chainarong681/portable-pcr-machine-project/README.md

โปรเจ็ค portable pcr machine project ของห้องปฏิบัติการไวรัสวิทยา ของศูนย์วิจัยและพัฒนาการสัตวแพทย์ภาคเหนือตอนล่างจังหวัดพิษณุโลก โดยนายชัยณรงค์ กุลฉิม นักวิทยาศาสตร์การแพทย์ปฏิบัติการ เริ่มต้นโปรเจ็ค 1 พ.ย. 2566
