chainarong681/portable-pcr-machine-project/poster and proceeding/Portable mini PCR และเครื่องตรวจสอบสารพันธุกรรม Isothermal แบบภาคสนาม final 10-1-2566.pdf

### Portable mini PCR และเครื่องตรวจสอบสารพันธุกรรม Isothermal แบบ ภาคสนาม

ความเป็นมา
ปัญหา : การแพร่ระบาดของโรคสัตว์และการติดต่อของโรคสัตว์สู่คนเป็นปัญหาที่ส าคัญ โดยเฉพาะ เชื้อก่อโรคที่ก่อความรุนแรงและมีอัตราการเสียชีวิตที่สูง วิธีการทดสอบที่ให้ผลที่รวดเร็วแบบ Point of care testing (PoCT) จึงมีบทบาทอย่างมากในการช่วยควบคุมโรคให้มีประสิทธิภาพ ปัจจุบันจึงมีการพัฒนาวิธีการ PoCT โดยใช้หลักการเพิ่มปริมาณสารพันธุกรรม Isothermal Amplification เช่นวิธี Loop-mediated isothermal amplification (LAMP) หรือ Recombinase polymerase amplification (RPA)ซึ่งเป็นวิธีการ ที่มีศักยภาพสูง รวดเร็ว สามารถตรวจได้ ณ จุดที่พบโรค แต่ก็ยังพบข้อจ ากัดอยู่ เช่น การอ่านผลได้หลายแบบ ท าให้สับสนในการเลือกใช้งาน ต้องอาศัยประสบการณ์ของผู้ทดสอบในการแปลผล และยังจ าเป็นต้องใช้ เครื่องมือเพิ่มปริมาณสารพันธุกรรม ซึ่งมีราคาค่อนข้างสูงแม้จะใช้เพียงอุณหภูมิเดียว
วัตถุประสงค์: การจัดการองค์ความรู้ในครั้งนี้มีเป้าหมายเพื่อ
1. พัฒนาเครื่องมือ PoCTต้นแบบขนาดเล็ก (Small Handheld PoCT devices) ได้แก่1) Portable mini PCR และ 2) เครื่องตรวจสอบสารพันธุกรรม Isothermal แบบภาคสนาม
2. ทดสอบการใช้งานโดยเลือกใช้วิธี LAMP เป็นต้นแบบ ตรวจหาสารพันธุกรรมของเชื้อไวรัส LSDV จากตัวอย่าง เลือด และตุ่มเนื้อเยื่อ (Laohasatian et al., 2023) โดยท าการปรับวิธีและสารเคมีให้เหมาะสม กับเครื่องต้นแบบ ใช้สีฟลูออเรสเซนต์SYBR green I ในการอ่านและติดตามผลการทดสอบ

วิธีการ
ออกแบบเครื่องมือต้นแบบ โดยใช้ระบบควบคุมการท างานด้วยไมโครคอนโทรลเลอร์ชนิด ESP32 วัด อุณหภูมิทดสอบด้วยเซนเซอร์ชนิด DS18B20 เพื่อควบคุมอุณหภูมิblock ด้วย Peltier ผ่านสัญญาณ PWM ซึ่งควบคุมแบบ Proportional Integral Derivative Control (PID) และอ่านการเรืองแสงของสีSYBR green I ด้วยเซนเซอร์ตรวจวัดสเปกตรัมแสง AS7341 แสดงการประมวลบนจอ LCD ผ่านการสั่งงานบนอุปกรณ์ โทรศัพท์มือถือ

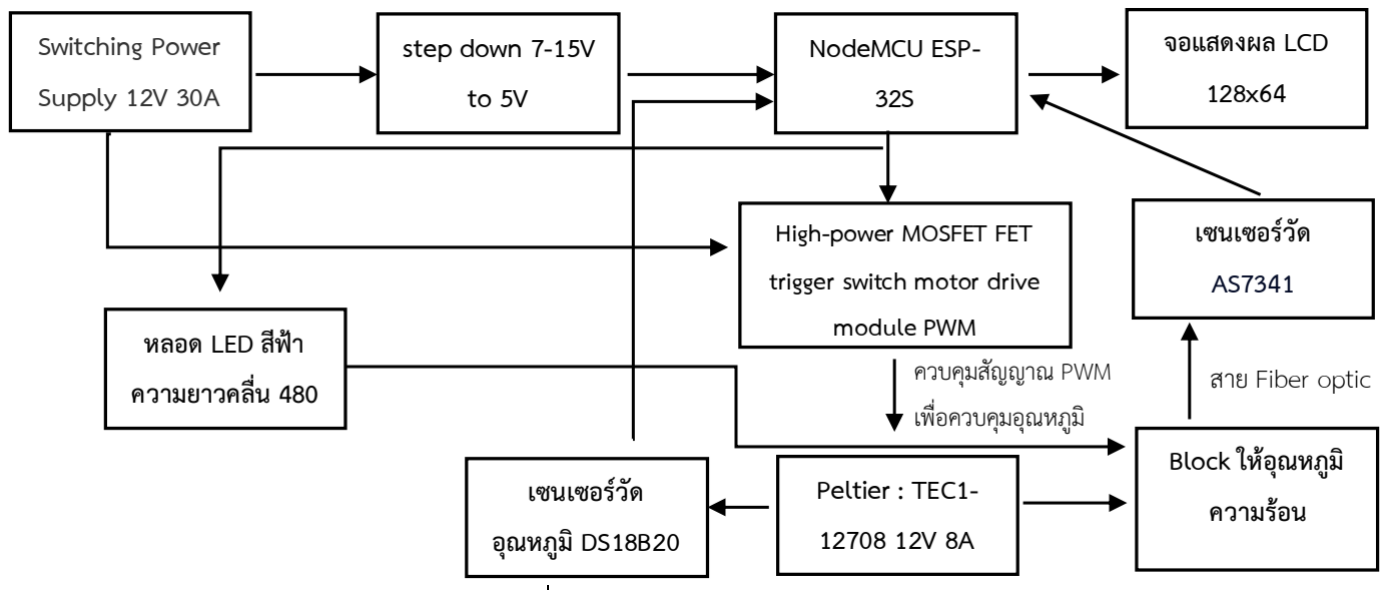
[picture p1: figure]

ภาพแสดงผังวงจรและระบบการท างานเครื่องตรวจสอบสารพันธุกรรม Isothermal แบบภาคสนามต้นแบบ

ผลลัพธ์
1. Portable mini PCR

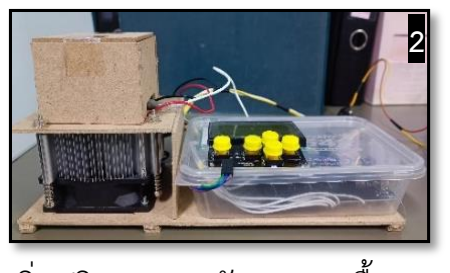
[picture p2: figure]
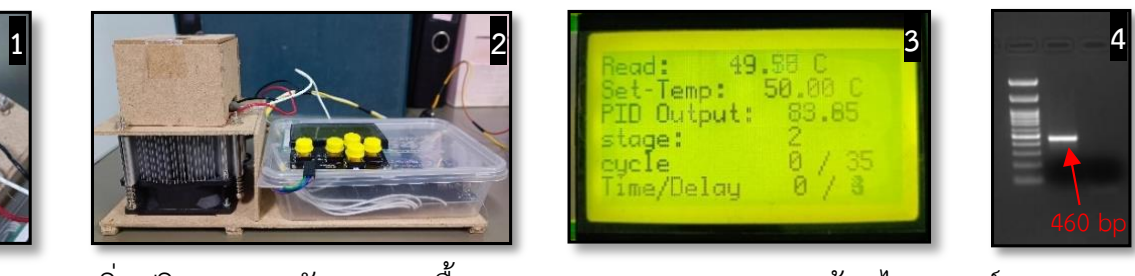
[picture p3: figure]
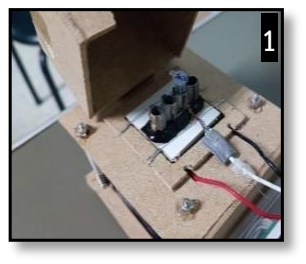
[picture p4: figure]

1.1 ผลการทดสอบเพิ่มปริมาณสารพันธุกรรมเชื้อ Pasteurella multocida ด้วยไพรเมอร์KMT1T7 และ KMT1SP6 (Moustafa et al., 2013) จากชุดเพิ่มปริมาณสารพันธุกรรม Invitrogen™ Platinum™ Taq DNA Polymerase ให้ผลการทดสอบขนาดดีเอ็นเอที่ถูกต้องเท่ากับ 460 bp (รูปที่ 4) ไม่พบ nonspecific band มีค่า Ramp rate เฉลี่ยประมาณ 3 ˚C/Sec (เครื่อง PCR ทางการค้ามีค่าเฉลี่ย 5 ˚C/Sec)
1.2 สามารถน าไปใช้ประโยชน์เป็นเครื่อง PCR ขนาดเล็ก พกพาสะดวก ใช้งานง่าย ใช้เป็น heat block ในการสกัดดีเอ็นเอด้วยวิธี Heat lysis
2. เครื่องตรวจสอบสารพันธุกรรม Isothermal แบบภาคสนาม

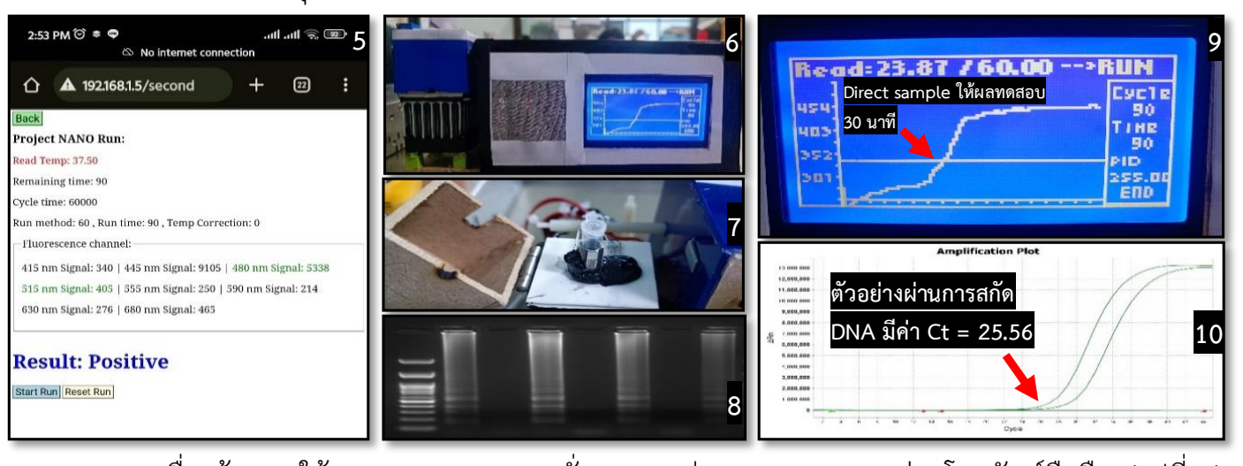
[picture p5: figure]
Direct sample ให้ผลทดสอบ 30 นาที; ตัวอย่างผ่านการสกัด DNA มีค่า Ct = 25.56

2.1 เครื่องต้นแบบใช้งานสะดวก สามารถสั่งงานและอ่านผลการทดสอบผ่านโทรศัพท์มือถือ (รูปที่ 5) มีขนาดเล็กพกพาได้(รูปที่ 6) เจ้าหน้าที่ด้านปศุสัตว์สามารถใช้งานได้ง่าย ราคาถูก ให้ผลรวดเร็ว น าไปใช้ใน การตรวจวินิจฉัย ติดตามอาการ และติดตามการรักษา และควบคุมโรคที่บริเวณหน้าฟาร์มหรือจุดเกิดโรค
2.2 ผลทดสอบการใช้งานตัวอย่างจากเลือดสดเจือจาง 1 : 50 ไม่ผ่านการสกัดสารพันธุกรรมให้ ผลบวกใช้เวลาน้อยกว่า 30 นาที(รูปที่ 9) เปรียบเทียบกับวิธีมาตรฐาน real-time PCR ตัวอย่างผ่านการสกัด ดีเอ็นเอ (รูปที่10) มีค่า Ct = 25.56 ให้ผลบวกภายในเวลา 66 นาทีดังนั้นวิธีนี้จึงเหมาะสมในการที่จะพัฒนา น าไปใช้จริงในภาคสนามต่อไป

น าเสนอโดย นายชัยณรงค์ กุลฉิม นักวิทยาศาสตร์การแพทย์ปฏิบัติการ ศูนย์วิจัยและพัฒนาการสัตวแพทย์ภาคเหนือตอนล่าง

การทดสอบเพื่อเพิ่มความถูกต้องของผลการ ทดสอบ สามารถท าการเจือจางเลือดสด 1:100 ผ่านการท า Heat lysis ที่ 95 ˚C นาน 5 นาที ก่อนท าการทดสอบด้วยวิธีLAMP

1:50 1:100 | ตัวอย่างคาดการว่ามีเชื้อไวรัสในปริมาณน้อยๆ
| (ไม่มีclinical sign) หรือพบค่า Ct จาก real- time PCR > 35 จ าเป็นต้องผ่านการท า Heat lysis ซึ่งจะให้ผลบวกระยะนานกว่า 60 นาที
