chainarong681/portable-pcr-machine-project/Isothermal/Nano_project_sensor24122023.ino

///////////////////////////ส่วน WIFI////////////////////////////////////////
#include <WiFi.h>
#include <WiFiClient.h>
#include <WebServer.h>
#include <ESPmDNS.h>
#include <EEPROM.h>

const char *ssid = "Project_nano";
const char *password = "123456789";

IPAddress apIP(192, 168, 1, 5);
IPAddress gatewayIP(192, 168, 1, 1);
IPAddress subnetIP(255, 255, 255, 0);

WebServer server(80);

///////////////////////////ส่วนแสดง LCD/////////////////////////////////////
#include <PID_v1.h>
#include <Arduino.h>
#include <U8g2lib.h>

#ifdef U8X8_HAVE_HW_SPI
#include <SPI.h>
#endif
#ifdef U8X8_HAVE_HW_I2C
#include <Wire.h>
#endif

U8G2_ST7920_128X64_F_SW_SPI u8g2(U8G2_R0, /* clock=*/18, /* data=*/23, /* CS=*/5, /* reset=*/22);  // ESP32

//loading bar
int boxlong = 0;

//Read temp ทุก 1 นาที
float READTEMP_ONE;

//อ่าน EEPROM เก็บเพื่อใช้เป็นค่า setting
//float methodRUN; //ย้ายไปใช้ที่ PID
int timeRUN;
float temCRUN;

//สถานะการทำงาน
int State_Run = 0;

//ประกาศตัวแปรเป็น global เพื่อเก็บค่าไว้ไม่ให้ reset จากการวนloop
unsigned long last_time = 0;
int period;  //ระยะเวลาสร้างกราฟที่ต้องการรอ 1 นาที (1000 * 60)
int TIME_COUNT = 0;
//Buzzer time count
unsigned long last_timeRead = 0;
unsigned long period2 = 1500;

// อ่านอุณหภูมิทุก 1 นาที แสดงที่จอ
unsigned long periodTemp = 1000; // ระยะเวลาที่ต้องการรอ
static unsigned long last_timeTempREAD = 0; // ประกาศตัวแปรเป็น static เพื่อเก็บค่าไว้ไม่ให้ reset จากการวน loop
float last_timeTemp;

//Set Line graph
float temperature[90];  // Array to store temperature values
int currentIndex;   // Index to keep track of the current position in the array

//คำนวนค่า max และ min กำหนดสเกลของกราฟเพื่อปรับความละเอียดตามค่า
int maxTemp;
int minTemp = 0;
//คำนวนค่าใส่เลเบลแกน Y
int percent20;
int percent40;
int percent60;
int percent80;

//Buzzer
#define BUZZER_PIN 13  // กำหนดขาที่เชื่อมต่อกับ buzzer
int Buzzer_count = 0;

// Control parameters for PID
double READTEMP, Output, methodRUN;
double Kp = 1; // Proportional gain 2 , 1
double Ki = 0.5; // Integral gain 5 , 0.5
double Kd = 0.5; // Derivative gain 1 , 0.5
PID myPID(&READTEMP, &Output, &methodRUN,Kp,Ki,Kd,P_ON_M, DIRECT);

// TEMP DS18B20
#include <OneWire.h>
#include <DallasTemperature.h>
#define ONE_WIRE_BUS 27
OneWire oneWire(ONE_WIRE_BUS);
DallasTemperature sensors(&oneWire);

// Peltier setup
int peltierPin = 33; // Digital pin connected to the Peltier module

//LED สีน้ำเงินเป็นแสง excitation
int ledBluePin = 12;

//AS7341 spectrum sensor
#include <Wire.h>
#include <Adafruit_AS7341.h>
Adafruit_AS7341 as7341;
int NM415; //ค่าอ่านที่ 415 nm
int NM445; //ค่าอ่านที่ 445 nm
int NM480; //ค่าอ่านที่ 480 nm
int NM515; //ค่าอ่านที่ 515 nm
int NM555; //ค่าอ่านที่ 555 nm
int NM590; //ค่าอ่านที่ 590 nm
int NM630; //ค่าอ่านที่ 630 nm
int NM680; //ค่าอ่านที่ 680 nm

//คำนวนค่า CT
float CT_value;
//คำนวนค่า Mean
float mean = 0.0;
float mean_val[20]; //เก็บค่า 20 ค่า
float sampleSumTotal = 0;
int mean_i; //ค่าที่จะให้รันซ้ำ
float SD_SumV = 0;
float Stdv_value = 0;
int SD_i;
//สถานะผลทดสอบ
String report_result;

/////////////////////////////////WIFI//////////////////////////////////////
// Function to write a string to EEPROM
void writeStringToEEPROM(int addr, const String &str) {
  for (size_t i = 0; i < str.length(); i++) {
    EEPROM.write(addr + i, str[i]);
  }
  EEPROM.write(addr + str.length(), '\0');  // Null-terminate the string
  EEPROM.commit();                          // Commit changes to EEPROM
}

// Function to read a string from EEPROM
String readStringFromEEPROM(int addr) {
  String result = "";
  char ch = EEPROM.read(addr);
  while (ch != '\0') {
    result += ch;
    addr++;
    ch = EEPROM.read(addr);
  }
  return result;
}

void handleRoot() {
  String html = "<html><body>";
  html += "<h1 style=\"color:blue;\">Project nano</h1>";
  html += "<h2 style=\"color:black;\">This project was developed by Mr. Chainarong Kulchim (medical scientist) </h2>";
  html += "<h2 style=\"color:black;\">Veterinary Research and Development Center Lower Northern Region</h2>";
  html += "<h2 style=\"color:black;\">9 Moo.15 Phitsanulok-Lomsak road Wangthong Phitsanulok 65130</h2>";
  html += "<h2 style=\"color:black;\">Email: chainarong681@gmail.com Tel.0805040716</h2>";

  // เพิ่มขนาดและเปลี่ยนสีปุ่ม
  html += "<button style=\"font-size: 30px; background-color: lightgreen;\" onclick=\"goToSecondPage()\">Run program</button>  ";
  html += "<button style=\"font-size: 30px; background-color: lightyellow;\" onclick=\"goToThirdPage()\">Setting program</button>  ";
  html += "<button style=\"font-size: 30px; background-color: lightpink;\" onclick=\"goToFourthPage()\">Calibration</button>";

  html += "<script>function goToSecondPage() { window.location.href = '/second'; }</script>";
  html += "<script>function goToThirdPage() { window.location.href = '/third'; }</script>";
  html += "<script>function goToFourthPage() { window.location.href = '/Fourth'; }</script>";
  html += "</body></html>";

  server.send(200, "text/html", html);
}

void handleSecondPage() {
  String html = "<html><body>";
  html += "<button style='font-size: 30px; background-color: lightgreen;' onclick='goToRoot()'>Back</button>";
  html += "<h1>Project NANO Run:</h1>";
  html += "<p style='font-size: 28px; color: red;'>Read Temp: " + String(last_timeTemp) + "</p>";
  html += "<p style='font-size: 28px;'>Remaining time: " + String(TIME_COUNT) + "</p>";
  
  // Read values from EEPROM
  String method = readStringFromEEPROM(0);
  String time = readStringFromEEPROM(5);
  String tempC = readStringFromEEPROM(10);
  String CycleTime = readStringFromEEPROM(40);

  // html += "<p style='font-size: 28px;'>Run method: " + method + "</p>";
  // html += "<p style='font-size: 28px;'>Run time: " + time + "</p>";
  // html += "<p style='font-size: 28px;'>Temp Correction: " + tempC + "</p>";

  //ตั้งค่าเวลาใน 1 cycle
  html += "<p style='font-size: 28px;'>Cycle time: " + CycleTime + "</p>";
  
  //เชื่อมต่อข้อความ
  html += "<p style='font-size: 28px;'>Run method: " + method + " \n " + ", Run time: " + time + " \n " + ", Temp Correction: " + tempC + "</p>";

  //แสดงสัญญาณ
  html += "<fieldset style='font-size: 28px;'>";
  html += "<legend>Fluorescence channel:</legend>"; // กำหนดชื่อ GroupBox ด้วย Legend
  html += "<p style='font-size: 25px;'>415 nm Signal: " + String(NM415) + " | " +
            "445 nm Signal: " + String(NM445) + " | <span style='color: green; font-size: 25px;'>480 nm Signal: " + String(NM480) + "</span></p>";
  html += "<p><span style='color: green; font-size: 25px;'>515 nm Signal: " + String(NM515) + "</span> | " +
            "555 nm Signal: " + String(NM555) + " | " +
            "590 nm Signal: " + String(NM590) + "</p>";
  html += "<p style='font-size: 25px;'>630 nm Signal: " + String(NM630) + " | " +
            "680 nm Signal: " + String(NM680) + "</p>";
  html += "</fieldset><br>";

  //ส่งผลการทดสอบ
  // html += "<h1 style='font-size: 55px; color: blue;'>Result: " + report_result + "</h1>";

 // Display test result with dynamic color
  html += "<h1 style='font-size: 55px; ";
  if (report_result == "Positive") {
    html += "color: red;'>Result: Positive</h1>";
  } else if (report_result == "Negative") {
    html += "color: green;'>Result: Negative</h1>";
  } else {
    html += "color: black;'>Please wait for test results after cycle 25</h1>";
  }
  
  // เพิ่มปุ่ม Start Run และ Stop Run
  html += "<button style='font-size: 28px; background-color: lightblue;' onclick='startRun()'>Start Run</button> ";
  html += "<button style='font-size: 28px; background-color: lightyellow;' onclick='resetRun()'>Reset Run</button> ";
  html += "<script>";
  html += "function startRun() {";
  html += "  if (confirm('Are you sure to start RUN?')) {";
  html += "    fetch('/startRun', { method: 'POST' })";
  html += "      .then(response => response.json())";
  html += "      .then(data => {";
  html += "        console.log('State_Run updated:', data.State_Run);";
  html += "      });";
  html += "  }";
  html += "}";
  html += "function resetRun() {";
  html += "  if (confirm('Are you sure you want to reset Run?')) {";
  html += "    fetch('/resetRun', { method: 'POST' })";
  html += "      .then(response => response.json())";
  html += "      .then(data => {";
  html += "        console.log('State_Run updated:', data.State_Run);";
  html += "      });";
  html += "  }";
  html += "}";
  html += "</script>";
  html += "<script>function goToRoot() { window.location.href = '/'; }</script>";
  html += "</body></html>";

  server.send(200, "text/html", html);
}

void handleThirdPage() {
  String html = "<html><body>";
  html += "<button style='font-size: 30px; background-color: lightgreen;' onclick='goToRoot()'>Back</button>";
  html += "<h1>Amplification method setting:</h1>";
  html += "<form action='/submit' method='post'>";
  html += "<label for='methods' style='font-size: 24px;'>Choose a method: </label>";
  html += "<select name='methods' id='methods' style='font-size: 24px;'>";
  html += "<option value='37'>Recombinase Polymerase Amplification(37 'C)</option>";
  html += "<option value='42'>Recombinase Polymerase Amplification(42 'C)</option>";
  html += "<option value='60'>Loop-mediated isothermal amplification(60 'C)</option>";
  html += "<option value='61'>Loop-mediated isothermal amplification(61 'C)</option>";
  html += "<option value='62'>Loop-mediated isothermal amplification(62 'C)</option>";
  html += "<option value='63'>Loop-mediated isothermal amplification(63 'C)</option>";
  html += "<option value='64'>Loop-mediated isothermal amplification(64 'C)</option>";
  html += "<option value='65'>Loop-mediated isothermal amplification(65 'C)</option>";
  html += "</select><br><br>";
  html += "<label for='time' style='font-size: 24px;'>Choose a time: </label>";
  html += "<select name='time' id='time' style='font-size: 24px;'>";
  html += "<option value='30'>30 min</option>";
  html += "<option value='60'>60 min</option>";
  html += "<option value='90'>90 min</option>";
  html += "<option value='2'>self test 2 min</option>";
  html += "</select><br><br>";
  html += "<label for='timeCycles' style='font-size: 24px;'>Please select the data collection time per cycle: </label>";
  html += "<select name='timeCycles' id='timeCycles' style='font-size: 24px;'>";
  html += "<option value='60000'>60 sec</option>";
  html += "<option value='1000'>1 sec</option>";
  html += "</select><br><br>";
  html += "<input type='submit' value='Submit' style='font-size: 20px; width: 100px; height: 30px; background-color: yellow;'>";
  html += "</form>";
  html += "<script>function goToRoot() { window.location.href = '/'; }</script>";
  html += "</body></html>";

  server.send(200, "text/html", html);
}

void handleThirdPageSubmit() {
  //////////////////////////ถ้าเขียน EEPROM แล้วมีปัญหา อาจเกิดการ reset อยู่ตลอดเวลให้แก้โดยใช้โค้ดลบ EEPROM ถึง 4096 และอัพโหลดโค้ดใหม่ดดยเลือก erase all flash ด้วยโดยทำตามลำดับ
  //////////////////////////หรือใช้วิธี ใช้โค้ดลบ EEPROM ถึง 4096 และอัพโหลดโค้ดใหม่ดดยเลือก erase all flash พร้อมกัน
  String method = server.arg("methods");
  String time = server.arg("time");
  String timeCycle = server.arg("timeCycles");

  // Assuming you have enough space in EEPROM for the method and time strings
  writeStringToEEPROM(0, method);
  writeStringToEEPROM(5, time);
  writeStringToEEPROM(40, timeCycle);

  // Print the saved values to Serial
  //Serial.println("Method: " + method);
  //Serial.println("Time: " + time);

  // Assuming you have some condition to determine success or failure
  bool success = true;  // Change this based on your actual condition

  String message;
  String color;

  if (success) {
    message = "Data saved successfully";
    color = "green";
  } else {
    message = "Failed to save data";
    color = "red";
  }

  String html = "<html><body>";
  html += "<h1 style='color:" + color + "'>" + message + "</h1>";
  html += "<button style='font-size: 30px; background-color: lightgreen;' onclick='goToThirdPage()'>Back</button>";
  html += "<script>function goToThirdPage() { window.location.href = '/third'; }</script>";
  html += "</body></html>";

  server.send(200, "text/html", html);
}

void handleFourthPage() {
  String html = "<html><body>";
  html += "<button style='font-size: 30px; background-color: lightgreen;' onclick='goToRoot()'>Back</button>";
  html += "<h1 style='font-size: 24px;'>Temperature calibration:</h1>";
  // เพิ่มฟอร์ม input ข้อมูล
  html += "<form action='/submitFourth' method='post' onsubmit='return validateForm()'>";
  html += "<label for='tempC' style='font-size: 24px;'>Temp correction ('C): </label>";
  html += "<input type='text' id='tempC' name='tempC' style='font-size: 24px;' required><br><br>";
  html += "<input type='submit' value='Submit' style='font-size: 20px; width: 100px; height: 30px; background-color: yellow;'>";
  html += "</form>";

  html += "<script>";
  html += "function validateForm() {";
  html += "  var tempCValue = document.getElementById('tempC').value;";
  html += "  if (!tempCValue || isNaN(tempCValue)) {";
  html += "    alert('Please enter a valid numeric value for Temp correction.');";
  html += "    return false;";
  html += "  }";
  html += "}";
  html += "</script>";


  html += "<script>function goToRoot() { window.location.href = '/'; }</script>";
  html += "</body></html>";

  server.send(200, "text/html", html);
}

void handleFourthPageSubmit() {
  String tempC = server.arg("tempC");

  // Assuming you have enough space in EEPROM for the tempC string
  writeStringToEEPROM(10, tempC);

  // Print the saved value to Serial
  //Serial.println("Temp Correction: " + tempC);

  // Assuming you have some condition to determine success or failure
  bool success = true;  // Change this based on your actual condition

  String message;
  String color;

  if (success) {
    message = "Temperature correction saved successfully";
    color = "green";
  } else {
    message = "Failed to save data";
    color = "red";
  }

  String html = "<html><body>";
  html += "<h1 style='color:" + color + "'>" + message + "</h1>";
  html += "<button style='font-size: 30px; background-color: lightgreen;' onclick='goToFourthPage()'>Back</button>";
  html += "<script>function goToFourthPage() { window.location.href = '/Fourth'; }</script>";
  html += "</body></html>";

  server.send(200, "text/html", html);
}
/////////////////////////////////WIFI//////////////////////////////////////

void setup(void) {
  WiFi.softAP(ssid, password);
  delay(100);

  WiFi.softAPConfig(apIP, gatewayIP, subnetIP);

  server.begin();

  server.on("/", HTTP_GET, handleRoot);

  server.on("/second", HTTP_GET, handleSecondPage);

  server.on("/third", HTTP_GET, handleThirdPage);
  server.on("/submit", HTTP_POST, handleThirdPageSubmit);  // New route for form submission

  server.on("/Fourth", HTTP_GET, handleFourthPage);
  server.on("/submitFourth", HTTP_POST, handleFourthPageSubmit);

  server.on("/startRun", HTTP_POST, [](){
  State_Run = 1; // ตั้งค่า State_Run เมื่อได้รับ request
  server.send(200, "application/json", "{\"State_Run\": 1}");
  });

  server.on("/resetRun", HTTP_POST, [](){
    State_Run = 4; // ตั้งค่า State_Run เมื่อได้รับ request
    server.send(200, "application/json", "{\"State_Run\": 4}");
  });

  //LCD
  u8g2.begin();

  // กลับจอ 180 องศา
  //u8g2.setDisplayRotation(U8G2_R2);

  //หน้าแรก
  u8g2.firstPage();
  do {
    u8g2.drawFrame(0, 0, 128, 64);

    u8g2.setDrawColor(1);                // 1 for solid color
    u8g2.setFont(u8g2_font_crox4tb_tf);  // Use a bold font, you can choose a different one if needed

    // Set the position to display "Project NANO" on the screen
    int x = 2;   // X coordinate
    int y = 30;  // Y coordinate
    u8g2.drawStr(x, y, "Project NANO");
    int i = 45;  // X coordinate
    int z = 50;  // Y coordinate
    u8g2.drawStr(i, z, "v0.1");

  } while (u8g2.nextPage());
  delay(5000);  // รอ 1 วินาที

  //หน้าสอง
  Page2();
  delay(5000);  // รอ 1 วินาที

  EEPROM.begin(512);  // Begin with EEPROM size

  pinMode(BUZZER_PIN, OUTPUT);  // กำหนดขา BUZZER_PIN เป็นขา output
  Buzzer_count = 0;

  // Initialize PID control
  myPID.SetMode(AUTOMATIC);

  // อ่านอุณหภูมิ DS18B20 Start up the library
  sensors.begin();
  //ลดระยะเวลาการอ่านอุณหภูมิให้สั้นลง
  //sensors.setWaitForConversion(false);
  //sensors.setResolution(9); // Set the resolution to 9-bit

  // Initialize the I2C port with custom SDA = 26 and SCL = 25 pins
  Wire.begin(26, 25);
  if (!as7341.begin()){
    Serial.println("Could not find AS7341");
    while (1) { delay(10); }
  }
  as7341.setATIME(100);
  as7341.setASTEP(999);
  as7341.setGain(AS7341_GAIN_256X);

  //Peltier
  pinMode(peltierPin, OUTPUT); //Peltier output

  //LED blue pin สำหรับ excitation
  pinMode(ledBluePin, OUTPUT);

  //wifi
  Serial.begin(115200);
  Serial.println("Access Point IP address: " + WiFi.softAPIP().toString());
  Serial.println("HTTP server started");
}

/////////////////////////////////LCD//////////////////////////////////////
void Page2(void) {
  u8g2.firstPage();
  do {
    u8g2.drawFrame(0, 0, 128, 64);

    u8g2.setDrawColor(1);               // 1 for solid color
    u8g2.setFont(u8g2_font_luBS08_te);  // Use a bold font, you can choose a different one if needed
    // Set the position to display "Project NANO" on the screen
    int a = 28;  // X coordinate
    int b = 15;  // Y coordinate
    u8g2.drawStr(a, b, "Develop by");
    int c = 2;   // X coordinate
    int d = 30;  // Y coordinate
    u8g2.drawStr(c, d, "Chainarong Kulchim");

    u8g2.setFont(u8g2_font_baby_tf);  // Use a bold font, you can choose a different one if needed
    int f = 12;                       // X coordinate
    int g = 47;                       // Y coordinate
    u8g2.drawStr(f, g, "(Medical scientist : VRDSN)");

    u8g2.setFont(u8g2_font_profont10_mr);  // Use a bold font, you can choose a different one if needed
    int h = 6;                             // X coordinate
    int i = 57;                            // Y coordinate
    u8g2.drawStr(h, i, "Chainarong681@gmail.com");

  } while (u8g2.nextPage());
}

//Loading Bar
void draw_box(u8g2_uint_t x, u8g2_uint_t y, u8g2_uint_t width, u8g2_uint_t height) {
  u8g2.drawBox(x, y, width, height);
}

void draw_loading_bar(u8g2_uint_t boxlong) {
  u8g2.firstPage();
  do {
    u8g2.setFont(u8g2_font_luBS08_te);  // Use a bold font, you can choose a different one if needed
    // Set the position to display "Project NANO" on the screen
    int x = 28;  // X coordinate
    int y = 20;  // Y coordinate
    u8g2.drawStr(x, y, "please wait");
    // Draw loading bar based on the value of boxlong
    draw_box(10, 27, boxlong, 10);
  } while (u8g2.nextPage());
  //delay(30);
}

/////////////////////////////////LCD//////////////////////////////////////
void loop(void) {
  //LCD
  //Loading bar
  if (boxlong < 108) {
    draw_loading_bar(boxlong);
    boxlong += 2;  // Increase boxlong or update it based on your logic
  } 
  else {
    //WIFI
    server.handleClient();

    //อ่านค่าตัวแปลไปเก็บเพื่อใช้เป็นค่า setting ในตอนกรณีที่เครื่องไม่อยู่ในสถานะการ Run ทำงาน
    if (State_Run != 1) {
      //อ่าน EEPROM เก็บที่ตัวแปล
      // อ่านค่าจาก EEPROM ที่ตำแหน่ง 0 และเก็บในตัวแปล methodRUN
      String methodRUN_EEPROM;
      EEPROM.get(0, methodRUN_EEPROM);
      methodRUN = methodRUN_EEPROM.toFloat();
      // อ่านค่าจาก EEPROM ที่ตำแหน่ง 5 (float มีขนาด 4 บิต) และเก็บในตัวแปล timeRUN
      String timeRUN_EEPROM;
      EEPROM.get(5, timeRUN_EEPROM);
      timeRUN = timeRUN_EEPROM.toFloat();
      // อ่านค่าจาก EEPROM ที่ตำแหน่ง 10 และเก็บในตัวแปล temCRUN
      String temCRUN_EEPROM;
      EEPROM.get(10, temCRUN_EEPROM);
      temCRUN = temCRUN_EEPROM.toFloat();
      // อ่านค่าจาก EEPROM ที่ตำแหน่ง 40 และเก็บในตัวแปล period
      String period_EEPROM;
      EEPROM.get(40, period_EEPROM);
      period = period_EEPROM.toFloat();
    }

    //อ่านอุณหภูมิ
    sensors.requestTemperatures(); // Send the command to get temperatures
    float tempC = sensors.getTempCByIndex(0);

    // Check if reading was successful
    if (!isnan(tempC)) {  // ตรวจสอบว่าค่าไม่ใช่ NaN
      READTEMP = tempC + temCRUN; //ส่งค่าที่ทำการวัด
    }

    //อ่านอุณหภูมิทุก X นาที แสดงที่จอ
     if (millis() - last_timeTempREAD > periodTemp) {
        last_timeTemp = READTEMP;
        last_timeTempREAD = millis();
        // Serial.println(last_timeTemp);
    }

    //Run program
    Run();
    //Serial.println(State_Run);
    
    //Peltier heat
    if (TIME_COUNT < timeRUN && State_Run == 1) {
      runInstrument();
    } else{
      analogWrite(peltierPin, 0); //ปิด peltier
    }
  }
}

void Run() {
 u8g2.firstPage();
  do {
    u8g2.drawFrame(0, 0, 128, 64); //สร้างกรอปล้อมรอบหน้าที่แสดง
    u8g2.setDrawColor(1);                    // 1 for solid color
    u8g2.setFont(u8g2_font_squeezed_b6_tr);  // Use a bold font, you can choose a different one if needed
    // Set the position to display "Project NANO" on the screen
    int a = 2;  // X coordinate
    int b = 8;  // Y coordinate
    u8g2.drawStr(a, b, "Read:");
    int c = 30;  // X coordinate
    int d = 8;   // Y coordinate
    u8g2.setCursor(c, d);
    u8g2.print(last_timeTemp, 2);
    // Set the position to display "Project NANO" on the screen
    int e = 57;  // X coordinate
    int f = 8;   // Y coordinate
    u8g2.drawStr(e, f, "/ ");
    int g = 63;  // X coordinate
    int h = 8;   // Y coordinate
    u8g2.setCursor(g, h);
    u8g2.print(methodRUN, 2);

    //สร้าง status ตอนรัน
    if (State_Run == 0) {
      u8g2.setFont(u8g2_font_squeezed_b6_tr);  // Use a bold font, you can choose a different one if needed
      int i = 90;                              // X coordinate
      int j = 8;                               // Y coordinate
      u8g2.drawStr(i, j, "-->WAIT");
    }
    if (State_Run == 1) {
      u8g2.setFont(u8g2_font_squeezed_b6_tr);  // Use a bold font, you can choose a different one if needed
      int i = 90;                              // X coordinate
      int j = 8;                               // Y coordinate
      u8g2.drawStr(i, j, "-->RUN");  
    }

    //ส่วนแสดงกราฟ
    //ตัวเลข เลเบล
    u8g2.setFont(u8g2_font_fourmat_te);  // Use a bold font, you can choose a different one if needed
    // Set the position to display "Project NANO" on the screen
    int n1 = 2;  // X coordinate
    int b1 = 53;  // Y coordinate
    u8g2.setCursor(n1, b1);
    u8g2.print(percent20);
  
    int n2 = 2;  // X coordinate
    int b2 = 43;  // Y coordinate
    u8g2.setCursor(n2, b2);
    u8g2.print(percent40);

    int n3 = 2;  // X coordinate
    int b3 = 33;  // Y coordinate
    u8g2.setCursor(n3, b3);
    u8g2.print(percent60);

    int n4 = 2;  // X coordinate
    int b4 = 23;  // Y coordinate
    u8g2.setCursor(n4, b4);
    u8g2.print(percent80);

    //วาดแกน
    // วาดเส้นแนวตั้งที่ตำแหน่ง x=5, y=10, ความยาว 50 pixel
    u8g2.drawVLine(15, 10, 50);
    // วาดจุดแนวตั้งที่ตำแหน่ง x=20, y=10 และห่างกันทีละ 5 จุด
    for (int i = 0; i < 15; i++) {
      u8g2.drawPixel(14, 10 + i * 5);
    }
    // วาดเส้นแนวนอนที่ตำแหน่ง x=5, y=60, ความยาว 91 pixel
    u8g2.drawHLine(15, 60, 91);
    // วาดจุดแนวนอนที่ตำแหน่ง x=5, y=61 และห่างกันทีละ 5 จุด
    for (int i = 0; i < 19; i++) {
      u8g2.drawPixel(15 + i * 5, 61);
    }

    //กล่อง parameter
    u8g2.drawFrame(105, 10, 24, 53);
    u8g2.setFont(u8g2_font_micro_mr);  // Use a bold font, you can choose a different one if needed
    int l = 107;                       // X coordinate
    int m = 18;                        // Y coordinate
    u8g2.drawStr(l, m, "Cycle");
    int n = 114;  // X coordinate
    int o = 25;   // Y coordinate
    u8g2.setCursor(n, o);
    u8g2.print(TIME_COUNT);

    int p = 107;                       // X coordinate
    int q = 32;                        // Y coordinate
    u8g2.drawStr(p, q, "Time");
    int p1 = 114;  // X coordinate
    int q1 = 39;   // Y coordinate
    u8g2.setCursor(p1, q1);
    u8g2.print(timeRUN);

    u8g2.setFont(u8g2_font_fourmat_tr);  // Use a bold font, you can choose a different one if needed
    int r = 107;                       // X coordinate
    int s = 46;                        // Y coordinate
    u8g2.drawStr(r, s, "PID");
    int p1w = 107;  // X coordinate
    int q1w = 53;   // Y coordinate
    u8g2.setCursor(p1w, q1w);
    u8g2.print(Output);


  //ตรวจสอบว่าอยู่ในสถานะ Run หรือไม่
      if (State_Run == 0) { //WAIT
        //Set time เท่ากับ 0
        TIME_COUNT = 0;  
        //LED blue pin OFF
        digitalWrite(ledBluePin, LOW);
        //ลบกราฟ
        clearGraph();
      } else if(State_Run == 1) { //RUN
        //Buzzer
          Buzzer();
        
        //LED blue pin ON
        digitalWrite(ledBluePin, HIGH);

        // Compute PID control
          myPID.Compute();

        //Time Run
          timer_RUN();

        //อ่านกราฟ
          Graph();
        
        //คำนวนค่า SD
        standardValue();
        
        //ตรวจสอบ Run complete
        if (TIME_COUNT >= timeRUN) {
          TIME_COUNT = timeRUN;
          u8g2.setFont(u8g2_font_micro_mr);  // Use a bold font, you can choose a different one if needed
          int i1 = 111;                              // X coordinate
          int j1 = 60;                               // Y coordinate
          u8g2.drawStr(i1, j1, "END");
          //LED blue pin OFF
          digitalWrite(ledBluePin, LOW);
        }

      }
      else if(State_Run == 4) { //Reset
        clearGraph();
        currentIndex = 0; //รีเซ็ทค่า currentIndex เริ่มต้นใหม่
        State_Run = 0;
        Buzzer_count = 0;

        //reset การคำนวนในฟังก์ชัน mean ให้เริ่มต้นใหม่
        for (int j = 0; j <= 20; j++) {
          mean_val[j] = 0;
        }
        mean_i = 0;
        sampleSumTotal = 0;
        mean = 0;
        SD_SumV = 0;
        Stdv_value = 0;
        SD_i = 0;

        //LED blue pin OFF
        digitalWrite(ledBluePin, LOW);

        // Reset ESP32
          // ESP.restart();

        //RESET PID output
          myPID.SetMode(MANUAL);
          Output = 0;
          myPID.SetMode(AUTOMATIC);
      }

} while (u8g2.nextPage());
 
}

void Buzzer(){
   if (millis() - last_timeRead > period2) {
    if (Buzzer_count <=2 && TIME_COUNT < 2){
      Buzzer_count ++;
      //Buzzer
      tone(BUZZER_PIN, 1000, 200);  // สร้างเสียงที่ความถี่ 1000 Hz และยาว 0.2 วินาที
    } else if (TIME_COUNT >= timeRUN && Buzzer_count <=12){
       Buzzer_count ++;
      tone(BUZZER_PIN, 1000, 200);  // สร้างเสียงที่ความถี่ 1000 Hz และยาว 0.2 วินาที
    }
    last_timeRead = millis();  //เซฟเวลาปัจจุบันไว้เพื่อรอจนกว่า millis() จะมากกว่าตัวมันเท่า period
  }
}

void timer_RUN() {
  if (millis() - last_time > period) {
    
    TIME_COUNT++;

    //ส่วนสร้างกราฟ
    if (currentIndex < timeRUN){ //เก็บค่าแค่ตาม setting ค่าเท่านั้น
      currentIndex++;
      //Serial.println(currentIndex);

    //อ่าน Sensors
    //AS7341 spectrum sensor
    // Read all channels at the same time and store in as7341 object
    NM415 = as7341.getChannel(AS7341_CHANNEL_415nm_F1);
    NM445 = as7341.getChannel(AS7341_CHANNEL_445nm_F2);
    NM480 = as7341.getChannel(AS7341_CHANNEL_480nm_F3);
    NM515 = as7341.getChannel(AS7341_CHANNEL_515nm_F4);
    NM555 = as7341.getChannel(AS7341_CHANNEL_555nm_F5);
    NM590 = as7341.getChannel(AS7341_CHANNEL_590nm_F6);
    NM630 = as7341.getChannel(AS7341_CHANNEL_630nm_F7);
    NM680 = as7341.getChannel(AS7341_CHANNEL_680nm_F8);

    temperature[currentIndex] = NM515;  //อ่าน Sensor ที่ 515nm

    if (!as7341.readAllChannels()){
      Serial.println("Error reading all channels!");
      return;
    }

    // Print out the stored values for each channel
    // Serial.print("F1 415nm : ");
    // Serial.println(as7341.getChannel(AS7341_CHANNEL_415nm_F1));
    // Serial.print("F2 445nm : ");
    // Serial.println(as7341.getChannel(AS7341_CHANNEL_445nm_F2));
    // Serial.print("F3 480nm : ");
    // Serial.println(as7341.getChannel(AS7341_CHANNEL_480nm_F3));
    // Serial.print("F4 515nm : ");
    // Serial.println(as7341.getChannel(AS7341_CHANNEL_515nm_F4));
    // Serial.print("F5 555nm : ");
    // Serial.println(as7341.getChannel(AS7341_CHANNEL_555nm_F5));
    // Serial.print("F6 590nm : ");
    // Serial.println(as7341.getChannel(AS7341_CHANNEL_590nm_F6));
    // Serial.print("F7 630nm : ");
    // Serial.println(as7341.getChannel(AS7341_CHANNEL_630nm_F7));
    // Serial.print("F8 680nm : ");
    // Serial.println(as7341.getChannel(AS7341_CHANNEL_680nm_F8));
    // Serial.print("Clear    : ");
    // Serial.println(as7341.getChannel(AS7341_CHANNEL_CLEAR));
    // Serial.print("Near IR  : ");
    // Serial.println(as7341.getChannel(AS7341_CHANNEL_NIR));
    }

    //คำนวนค่า mean
    meanValue();

    //วิเคราะห์ผล
    result_report();

    last_time = millis();  //เซฟเวลาปัจจุบันไว้เพื่อรอจนกว่า millis() จะมากกว่าตัวมันเท่า period
  }
}

void meanValue(){
  //คำนวนค่า Mean
  if (NM515 != 0){
    mean_i++;
        if (mean_i <= 20) {
          // อ่านข้อมูล 20 คำนวนค่า mean
          mean_val[mean_i] = NM515;
          sampleSumTotal += mean_val[mean_i];
          mean = sampleSumTotal/20;

          // Print mean, standard deviation, and maximum temperature
          Serial.print("mean_i: ");
          Serial.println(mean_i);
          Serial.print("sampleSumTotal: ");
          Serial.println(sampleSumTotal);
          Serial.print("Mean: ");
          Serial.println(mean);
      }
  }

}

void standardValue(){
   //คำนวนค่า Standard deviation
   if (currentIndex >21) {
      SD_i++;
      if (SD_i <= 20) {
          SD_SumV += pow((mean - mean_val[SD_i]),2);
          Stdv_value = sqrt(SD_SumV/19); //N-1

          //คำนวน CT จาก 3SD (99.73%) , 4SD มีค่า >100%
          CT_value = mean + (Stdv_value * 4);

          // Print mean, standard deviation, and maximum temperature
          Serial.print("number i: ");
          Serial.println(SD_i);
          Serial.print("Stdv_value: ");
          Serial.println(Stdv_value);
      }
   } 
}

// กราฟเส้นแนวตั้ง
void Graph() {
  if (currentIndex > 0 && currentIndex <= timeRUN) {
      // คำนวณค่า max อ่านค่าทุกช่วงการวัด
      maxTemp = temperature[0];    
      for (int i = 0; i < timeRUN; i++) {
        if (temperature[i] > maxTemp) {
          maxTemp = temperature[i];
        }
      }

      // คำนวณค่า min อ่านค่า 20 นาทีแรก
      const int arraySize = 20;  // กำหนดขนาดของอาเรย์
      minTemp = temperature[arraySize];
      for (int i = 0; i < arraySize; i++) {
        if (temperature[i] != 0 && (minTemp == 0 || temperature[i] < minTemp)) {
          minTemp = temperature[i];
        }
      }
      // Serial.print("maxTemp: ");
      // Serial.println(maxTemp);
      // Serial.print("minTemp: ");
      // Serial.println(minTemp);
  }
      // วนลูปเพื่อวาดกราฟเส้น
      //10 คือสเกลที่บวกเพิ่มให้บวกจากค่า max สุดท้ายที่ทำการวัดได้
      for (int igraph = 1; igraph < timeRUN - 1; igraph++) {
        // คำนวณตำแหน่ง y สำหรับกราฟเส้นทั้งสอง
        int yPos1 = map(temperature[igraph], minTemp, maxTemp + 10, 60, 10);
        int yPos2 = map(temperature[igraph + 1], minTemp, maxTemp + 10, 60, 10);
        
        // วาดเส้นระหว่างจุด
        u8g2.drawLine(14 + igraph, yPos1, 14 + igraph, yPos2);

        // วาด Scatter plot
        // u8g2.drawHLine(15 + igraph, yPos1, 1);

        // สร้างเส้น CT
        // ตำแหน่งเริ่มต้นของเส้นตรง
        if (currentIndex > 25) {
          int startX = 15;
          int endX = 105;
          int targetY = map(CT_value, minTemp, maxTemp + 10, 60, 10); // แปลงค่า CT_value เป็นระหว่าง 10 ถึง 60

          // วาดเส้นตรง
          u8g2.drawLine(startX, targetY, endX, targetY);

          // วาดจุดต่อจุดทีละ 5 จุด
          // for (int x = startX; x <= endX; x += 5) {
          //   u8g2.drawPixel(x, targetY);
          // }
        }
        //คำนวนค่าใส่ในสเกลแกน Y จากค่า max
        int yvalue = ((maxTemp + 10) - minTemp) / 5;
        percent20 = minTemp + yvalue;
        percent40 = minTemp + (yvalue * 2);
        percent60 = minTemp + (yvalue * 3);
        percent80 = minTemp + (yvalue * 4);
      }
}

void clearGraph() { //เคลียร์หน้าจอ
  for (int i = 0; i < timeRUN; i++) {
    temperature[i] = 0;
  }
}

//Run temp
void runInstrument(){
  //Protect >=70 และป้องกัน PID จ่ายกระแสเกิน 150
  if ((READTEMP >= methodRUN) || (READTEMP >= 70) || (Output > 150)) {
      analogWrite(peltierPin, 0); //ปรกติจะเท่ากับ 0
    } else {
      analogWrite(peltierPin, Output);
    }
}

void result_report(){
  if (currentIndex > 25 && currentIndex <= timeRUN) {
    if (NM515 >= CT_value ){
      report_result = "Positive";
    } else{
      report_result = "Negative";
    }
  }
}
