chainarong681/portable-pcr-machine-project/(commit log)

2023-11-03 เริ่มต้นโปรเจค
2023-11-04 เพิ่มงานเก่า LCD graph
2023-11-04 LCD จอใหม่
2023-11-05 LCD และ DS18B20
2023-11-05 LCD FAN และ DS18B20
2023-11-05 PID control 5-11-2566
2023-11-05 กำลังพัฒนา 5-11-2566
2023-11-08 ใหม่
2023-11-09 Update ใช่ switch case
2023-11-09 Update ChatGPT ใช้ switch case
2023-11-11 ใหม่ 11-11-2566
2023-11-11 Final project Chim 11-11-2566 ใช้จริง
2023-11-12 รอทำ
2023-11-12 Create GPT แก้ไข keypad
2023-11-15 ใช้จริง
2023-11-16 ทดสอบ amplify ตัวอย่าง PI-3 ด้วย one-step SSIII
2023-11-16 กำลังพัฒนา
2023-11-16 Update โปรเจคแก้ไข
2023-11-17 ใหม่สุด 17-11-2566
2023-11-18 Create ChatGPT แก้ไขโค้ดให้ 18-11-2023
2023-11-18 18 แก้ไขใหม่ new ใช้ได้
2023-11-19 ปรับแก้ใหม่ 19 พ.ย. 2566
2023-11-19 20 พ.ย. 2566 ใช้ค่าแก้ใช้งานจริง
2023-11-20 โค้ดสุดท้ายใช้จริง 20-11-2566
2023-11-20 ปรับพัดลม 21-11-2566
2023-11-20 Update 22-11-2566 ปรับพัดลม
2023-11-21 Update 22-11-2566แก้ไขใหม่
2023-11-22 โค้ดสมบูรณ์แก้ไขการชดเชยเวลาแล้ว 22-11-2566
2023-11-24 Create Analytik Jena และเปรียบเทียบ Project
2023-11-24 Update Analytik Jena และเปรียบเทียบ Project
2023-11-25 Create ESP32
2023-11-26 Update ESP32
2023-11-26 Create ESP32 webpage
2023-11-26 Update ESP32 webpage
2023-11-26 Create ESP32 webpage input
2023-11-26 Update ESP32 webpage input and EEPROM
2023-11-26 Update ESP32 webpage input 5.00
2023-11-26 Update ESP32 webpage input 6.41
2023-11-26 Update ESP32 webpage input 5.45
2023-11-26 Update ESP32 webpage input
2023-11-27 Update ESP32 webpage input 27-11-2566
2023-11-27 Update ESP32 webpage input EEPROM สมบูรณ์
2023-11-28 Librsry สำหรับการ Upload ของ ESP32
2023-11-28 Library สำหรับการ Upload ของ ESP32
2023-11-30 ESp32 LCD
2023-11-30 Create ESP32-LCD-WIFI
2023-12-03 Project NANO ใช้ได้ final
2023-12-04 Create รอพัฒนา
2023-12-04 ใหม่ 5-12-2566
2023-12-09 Update 8-12-2566 NEW PID แก้ไข
2023-12-10 Update 11-12-2566 แก้ไข PID seset
2023-12-10 Update 10_12_2566_ProjectNANO.ino แก้ไข PID Reset
2023-12-23 Create NANO ใส่ sensor
2023-12-23 Update NANO ใส่ sensor
2023-12-24 Nono project ใส่ sensor
2023-12-28 Update and rename NANO ใส่ sensor to NANO ใส่ sensor อัพเดท
2023-12-29 Update NANO ใส่ sensor อัพเดท
2024-01-02 Update Nano_project_sensor2_2_2567.ino
    แก้ไขค่าสถิติแล้ว
